cornfieldliving-nhb/MEAM-5290/modal-2.png

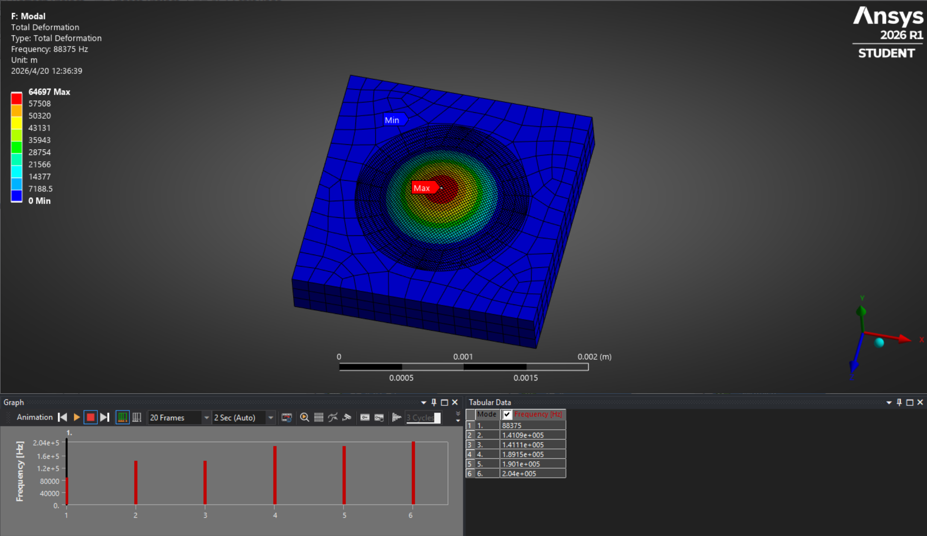
modal-2.png
