cornfieldliving-nhb/MEAM-5290/static_structural-2.png

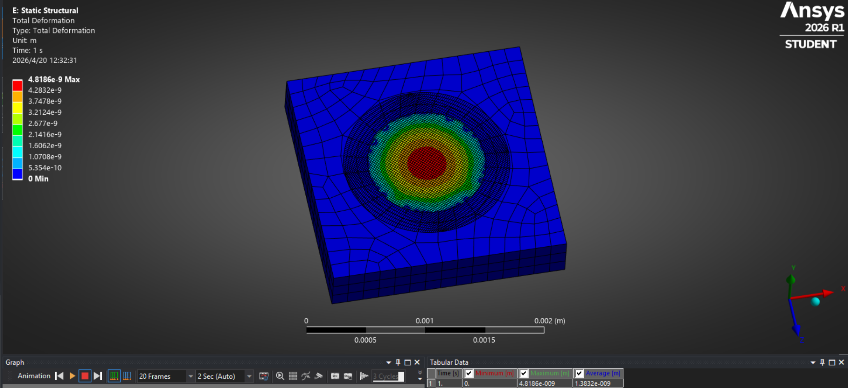
static_structural-2.png
