cornfieldliving-nhb/MEAM-5290/microphone_design.png

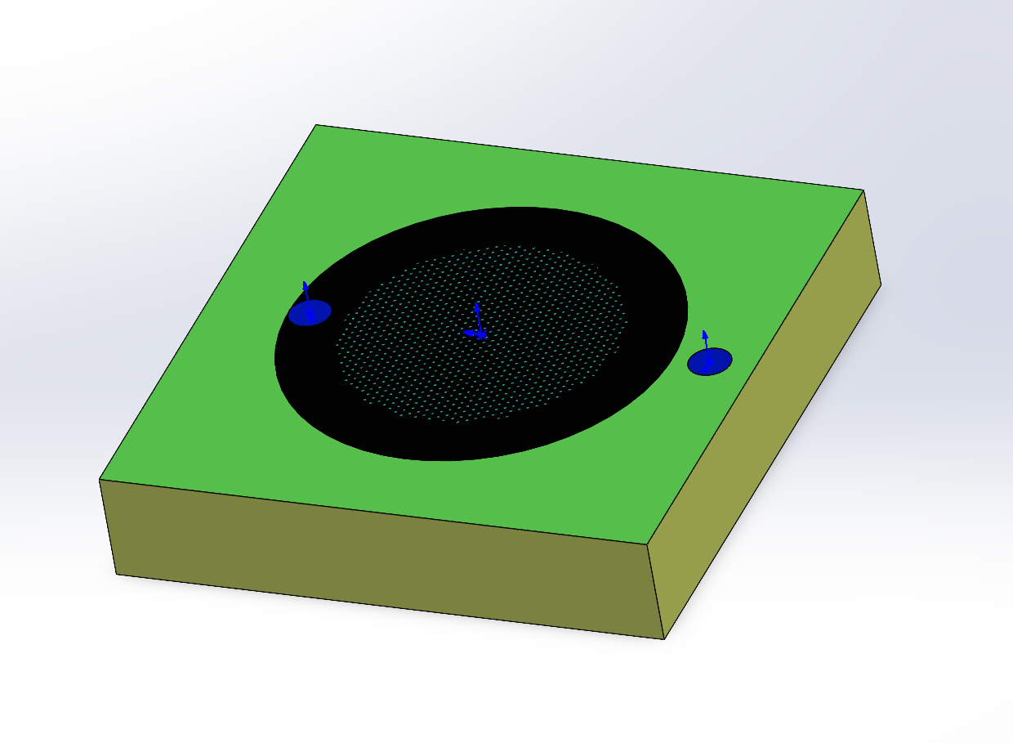
microphone_design.png
