cornfieldliving-nhb/MEAM-5290/assembly.SLDASM

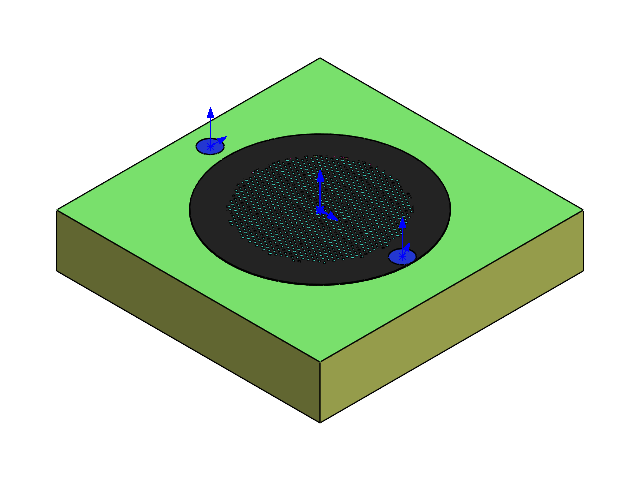
[picture p10: CAD file, 2026-05-05]
assembly.SLDASM
isolation
diaphragm
anchors
backplate
pads x 2
substrate
